varo-wah/wro-angklung-ai-player/docs/hardware.md

# Hardware

## Current Status

The Python pipeline still uses placeholder actuator functions. The website Web Serial driver supports channels 0-17 and sends validated `actuator_schedule.v1` commands to the Arduino Mega firmware. Pause, Stop, completion, and disconnect command all outputs off; E-Stop also disarms firmware output.

The canonical channel, G3-C6 note, angklung-number, and latest physically sweep-tested pin-pair mapping is in `hardware/arduino/README.md`. Firmware uses non-blocking software PWM on the first pin of every driver pair, so ordinary Mega digital pins remain power-adjustable. Every two-pin motor pair remains intact and IN1/IN2 are not reversed. Channel 13 remains assigned to pins 38,39 pending separate diagnosis of its missing physical hit. The corrected firmware compiles successfully but must still be uploaded before this mapping controls the rack.

## Expected Hardware Direction

Future hardware work may include:

- One actuator per angklung note.
- A motor driver, servo driver, relay board, or solenoid driver depending on the final mechanism.
- A microcontroller for precise low-level timing.
- A host computer or single-board computer for AI-assisted song selection and high-level scheduling.

## Hardware Boundary

Python hardware code should enter through `src/actuator_controller.py`. Browser-operated hardware code enters through `frontend/src/lib/arduinoSerial.ts` and the versioned serial protocol in `hardware/arduino/mega_full_18_note/mega_full_18_note.ino`.

The rest of the system should not know whether a note is played by:

- A print statement.
- A GPIO pin.
- A serial command.
- A microcontroller protocol.

This boundary keeps scheduling testable and prevents hardware experiments from destabilizing core playback logic.

## Risks To Validate Later

- Mechanical response delay.
- Actuator reset time.
- Missed or overlapping notes.
- Power draw during chords.
- Timing jitter between host software and physical movement.
- Angklung resonance and damping behavior.
