varo-wah/wro-angklung-ai-player/docs/software.md

# Software

## Current Target

The software target is a website-based AI Angklung Performance Console with reliable control flow before any physical actuator is connected.

The official build order is:

1. Phase 1: Website/control UI and chatbot-style assistant.
2. Phase 2: Reliable preloaded song library and simple song playback.
3. Phase 3: YouTube Piano Reference Mode with user approval.
4. Phase 4: Optional automatic YouTube search plus camera/voice interaction.
5. Phase 5: Hardware driver using the same `actuator_schedule.v1` format.

The current pipeline is:

```text
YouTube URL -> mocked transcription -> internal song JSON -> actuator_schedule.v1
song JSON -> song parser -> instrument mapper -> note scheduler -> actuator controller placeholder
guest request or control-panel selection -> built-in frontend song -> actuator_schedule.v1 -> shared website simulator state
```

The YouTube path is architecture preparation only. It validates source input and produces deterministic mocked notes; it does not search YouTube, download audio, or perform real transcription.

The reliable path is the preloaded supported song library. If a requested song is not preloaded, the frontend must show a limitation message and the future YouTube approval placeholder. It must not imply that every arbitrary song can be played.

The active Phase 2 test library currently keeps `A Whole New World` and the MuseScore-derived `Perfect` arrangement playable on the corrected G3-C6 rack. The older Perfect draft remains inactive because it still uses the old G4-C7 rack and needs remapping. The active arrangements are layered G3-C6 drafts with upper melody notes and lower physical accompaniment. They are playable in the simulator, but remain `demo_safe: false` until listening review, simplification, and hardware validation are complete.

## Song Format

Songs are JSON objects with metadata and a list of notes:

```json
{
  "title": "Example Angklung Pattern",
  "tempo_bpm": 120,
  "notes": [
    {"note": "G4", "start": 0.0, "duration": 0.5}
  ]
}
```

Fields:

- `title`: human-readable song name.
- `tempo_bpm`: positive integer tempo metadata.
- `notes`: non-empty list of note events.
- `note`: angklung note name.
- `start`: note start time in seconds from the beginning of playback.
- `duration`: intended note duration in seconds.

## Timing Model

The scheduler uses monotonic time. This is the correct clock for elapsed-time playback because it is not affected by wall-clock updates.

The scheduler currently:

- Sorts notes by `start`.
- Converts relative note starts into absolute monotonic target times.
- Sleeps until each target time.
- Calls the actuator boundary with expected start time, actual start time, and drift.

## Instrument Mapping

Instrument mappings are stored in `config/instrument_map.json`.

The current physical range is modeled as 18 diatonic notes:

```text
G3 A3 B3 C4 D4 E4 F4
G4 A4 B4 C5 D5 E5 F5
G5 A5 B5 C6
```

Each playable note must resolve to:

- `instrument_id`: the physical angklung identifier.
- `actuator_channel`: the placeholder channel that will later correspond to hardware routing.

Playback fails before scheduling if any song note is missing from the map. Partial playback is not allowed at this stage.

The frontend mirrors this as the current G3-C6 rack in `frontend/src/lib/instrumentMap.ts`. Future conversion must reject unsupported notes such as sharps/flats unless they can be simplified safely into the supported range.

## Actuator Schedule Export

The official command export format is `actuator_schedule.v1`.

Generate an actuator schedule JSON file with:

```bash
python3 src/main.py --song songs/example_song.json --driver json --export outputs/example_schedule.json
```

The export is relative to playback start and is intended for the future website, simulator, and hardware controller layers.

## Website Simulator

The frontend simulator lives in `frontend/`.

It now acts as the Phase 1 AI Angklung Performance Console with three route-based screens:

- `/guest`: a visitor-facing chatbot interface for song requests, supported-song suggestions, simplified playback, and clear unsupported-song messaging.
- `/control`: an operator-facing system monitor with built-in song selection, arrangement controls, schedule generation, validation, virtual rack playback, oscillator tones, timeline preview, JSON preview, and advanced `actuator_schedule.v1` upload.
- `/display`: an audience-facing performance display with assistant status, latest request, selected song, now-playing state, and a decorative music sheet preview.

The screens share frontend state during the browser session. A supported request on `/guest` generates the same schedule and validation state shown on `/control` and the same presentation state shown on `/display`.

For Phase 1 multi-screen demos, browser tabs synchronize through `BroadcastChannel` with `localStorage` as a hydration backup. No backend database is required yet. The tab that starts playback controls audio, while the other tabs mirror playback status and progress visually.

The Phase 2 active song library is currently reset to one test arrangement: `Perfect`. It is loaded from `frontend/public/songs/arrangements/perfect.json` through `frontend/public/songs/catalog.json`, and is marked as a MIDI-derived draft that still needs simplification. It is not demo-safe.

The assistant can match supported song requests against the active library, generate `actuator_schedule.v1`, run validation, and prepare simulation playback when validation does not fail. Unsupported requests show that YouTube Piano Reference Mode is coming later, would require user approval, and that no audio download or transcription is currently running.

Run it with:

```bash
cd frontend
npm install
npm run dev
```

## Testing

Run tests with:

```bash
python3 -m pytest
```

If using the local virtual environment created during setup:

```bash
.venv/bin/python -m pytest
```

## Known Limits

- No hardware control is implemented.
- No real YouTube search, audio download, transcription, camera detection, or voice input is implemented.
- Drift is reported in terminal output, but it is not persisted yet.
- Simultaneous notes are scheduled sequentially in sorted order.
- Tempo is stored as metadata, but notes currently use seconds rather than beats.
