varo-wah/wro-angklung-ai-player/docs/ai/knowledge/wro-demo-explanation.md

# WRO demo explanation

Judge-friendly summary: Angklobot is a local AI-powered robotic angklung system that lets a visitor converse with the machine, choose from validated music, and watch a safe digital arrangement become synchronized angklung actuation.

The AI contribution is local Ollama conversation, intent interpretation, catalog-grounded matching, and recommendations. The robotics contribution is converting validated musical timing into an actuator schedule for a motorized 18-note angklung rack. Validation matters because a plausible AI response is not sufficient evidence that pitches, overlaps, or timings are physically safe.

Local Ollama allows the demo to run on a WRO laptop without depending on cloud connectivity and keeps response data on the machine. Microphone input, local Whisper transcription, the “Hey Angklobot” phrase, text-to-speech, and local MIDI conversion are implemented software features. Camera-based presence detection and complete physical-hardware validation remain future work.
