varo-wah/wro-angklung-ai-player/docs/song-list.md

# Current song list — 10 September 2026

35 musical arrangements and 4 hardware tests are active (39 entries). The legacy out-of-range Perfect draft is inactive; the playable Perfect is the reviewed MuseScore arrangement.

## Pop & ballads (16)

- A Sky Full of Stars
- A Thousand Years
- All of Me
- Count on Me
- Die With a Smile
- Fireflies
- Just the Way You Are
- Love Story
- Memories
- Peaches
- Perfect
- Photograph
- See You Again
- Shape of You
- Someone You Loved
- You Are the Reason

## Rock & classics (4)

- Can't Help Falling in Love
- Viva La Vida
- We Are the Champions
- Yellow

## Film & musicals (5)

- A Whole New World
- Golden
- Let It Go
- Mission: Impossible Theme
- Under the Sea

## Traditional & folk (4)

- Bengawan Solo
- Bubuy Bulan
- Manuk Dadali
- Tokecang

## Indonesian national (3)

- Indonesia Pusaka
- Indonesia Raya
- Tanah Airku

## Indonesian pop (2)

- Lantas
- Laskar Pelangi (supplied-score draft)

## Instrumental (1)

- River Flows in You

## Hardware tests (4)

- 5-7-2-4 Cycle
- 5-7-2-4 Ping-Pong
- Cross Pattern
- Full Rack Sweep

We Are the Champions starts at its first chorus. Melody only / Melody with Extra is available across the library; Extra plays only the authored support parts when present. All scheduled holds follow the two-second cap and release-gap policy.
