varo-wah/wro-angklung-ai-player/frontend/scripts/sources/You_Are_The_Reason_Dynamic_Hold_Softer_Lows.ino

/*
  YOU ARE THE REASON - ANGKLOBOT
  Target: Arduino Mega 2560

  Motor system:
    - 18 channels
    - paired IN1 / IN2 pins
    - software PWM at 1 kHz
    - individual motor power percentages
    - note-length-aware motor pulses up to 300 ms
    - non-blocking playback for overlapping notes

  Song:
    - full 827-event arrangement
    - manual start only; no autoplay

  Serial:
    P = play/restart
    S = stop
    T = status
*/

#include <Arduino.h>
#include <avr/pgmspace.h>

constexpr uint8_t CHANNEL_COUNT = 18;
constexpr uint16_t PWM_PERIOD_US = 1000;
constexpr uint16_t MAX_PULSE_DURATION_MS = 300;
constexpr unsigned long SERIAL_BAUD = 115200;

// 0=G3, 1=A3, 2=B3, 3=C4, 4=D4, 5=E4, 6=F4,
// 7=G4, 8=A4, 9=B4, 10=C5, 11=D5, 12=E5,
// 13=F5, 14=G5, 15=A5, 16=B5, 17=C6

const uint8_t IN1_PINS[CHANNEL_COUNT] = {
  6, 8, 2, 4, 28, 26, 32, 30, 12,
  10, 24, 22, 36, 34, 41, 38, 44, 42
};

const uint8_t IN2_PINS[CHANNEL_COUNT] = {
  7, 9, 3, 5, 29, 27, 33, 31, 14,
  11, 25, 23, 37, 35, 42, 39, 45, 43
};

// Per-note power percentages.
uint8_t motorPowerPercent[CHANNEL_COUNT] = {
  50, 40, 40, 40, 40, 40, 40, 40, 40,
  40, 50, 40, 40, 40, 40, 40, 40, 40
};

struct MotorState {
  bool active;
  bool outputHigh;
  uint16_t dutyPermille;
  unsigned long pulseEndMs;
  unsigned long pwmCycleStartUs;
};

MotorState motors[CHANNEL_COUNT];

struct __attribute__((packed)) SongEvent {
  uint32_t startMs;
  uint16_t durationMs;
  uint8_t channel;
};

const SongEvent SONG[] PROGMEM = {
  {0UL, 260, 3},
  {350UL, 148, 0},
  {700UL, 148, 0},
  {1045UL, 148, 3},
  {1395UL, 148, 0},
  {1745UL, 148, 0},
  {2095UL, 148, 3},
  {2440UL, 148, 0},
  {2790UL, 148, 0},
  {3140UL, 148, 3},
  {3490UL, 148, 0},
  {3835UL, 148, 0},
  {4185UL, 260, 1},
  {4185UL, 148, 3},
  {4535UL, 148, 0},
  {4885UL, 148, 0},
  {5235UL, 148, 3},
  {5580UL, 148, 0},
  {5930UL, 148, 0},
  {6280UL, 148, 3},
  {6630UL, 148, 0},
  {6975UL, 148, 0},
  {7325UL, 148, 3},
  {7675UL, 148, 0},
  {8025UL, 148, 0},
  {8370UL, 148, 3},
  {8370UL, 260, 6},
  {8720UL, 148, 0},
  {9070UL, 148, 0},
  {9420UL, 148, 3},
  {9765UL, 148, 0},
  {10115UL, 148, 0},
  {10465UL, 260, 0},
  {10465UL, 148, 2},
  {10815UL, 148, 0},
  {11165UL, 148, 0},
  {11510UL, 148, 2},
  {11860UL, 148, 0},
  {12210UL, 148, 0},
  {12560UL, 260, 3},
  {12905UL, 148, 0},
  {13255UL, 148, 0},
  {13605UL, 148, 3},
  {13955UL, 148, 0},
  {14300UL, 148, 0},
  {14650UL, 148, 3},
  {15000UL, 148, 0},
  {15350UL, 148, 0},
  {15700UL, 148, 3},
  {15700UL, 257, 12},
  {16045UL, 148, 0},
  {16045UL, 257, 11},
  {16395UL, 148, 0},
  {16395UL, 257, 10},
  {16745UL, 260, 3},
  {16745UL, 300, 10},
  {17095UL, 148, 0},
  {17440UL, 148, 0},
  {17790UL, 148, 3},
  {17790UL, 300, 10},
  {18140UL, 148, 0},
  {18490UL, 148, 0},
  {18490UL, 257, 8},
  {18835UL, 148, 3},
  {19185UL, 148, 0},
  {19535UL, 148, 0},
  {19535UL, 257, 7},
  {19885UL, 148, 3},
  {19885UL, 257, 10},
  {20235UL, 148, 0},
  {20235UL, 257, 11},
  {20580UL, 148, 0},
  {20580UL, 257, 12},
  {20930UL, 260, 1},
  {20930UL, 148, 3},
  {20930UL, 300, 10},
  {21280UL, 148, 0},
  {21630UL, 148, 0},
  {21630UL, 300, 8},
  {21975UL, 148, 3},
  {22325UL, 148, 0},
  {22675UL, 148, 0},
  {23025UL, 148, 3},
  {23370UL, 148, 0},
  {23720UL, 148, 0},
  {23720UL, 257, 7},
  {24070UL, 148, 3},
  {24070UL, 257, 10},
  {24420UL, 148, 0},
  {24420UL, 257, 11},
  {24765UL, 148, 0},
  {24765UL, 257, 12},
  {25115UL, 148, 3},
  {25115UL, 260, 6},
  {25115UL, 300, 8},
  {25465UL, 148, 0},
  {25815UL, 148, 0},
  {26165UL, 148, 3},
  {26510UL, 148, 0},
  {26860UL, 148, 0},
  {27210UL, 260, 0},
  {27210UL, 148, 2},
  {27560UL, 148, 0},
  {27905UL, 148, 0},
  {27905UL, 257, 10},
  {28255UL, 148, 2},
  {28255UL, 300, 10},
  {28605UL, 148, 0},
  {28955UL, 148, 0},
  {28955UL, 257, 4},
  {29300UL, 260, 3},
  {29300UL, 300, 5},
  {29650UL, 148, 0},
  {30000UL, 148, 0},
  {30350UL, 148, 3},
  {30700UL, 148, 0},
  {31045UL, 148, 0},
  {31395UL, 148, 3},
  {31745UL, 148, 0},
  {32095UL, 148, 0},
  {32270UL, 128, 10},
  {32440UL, 148, 3},
  {32440UL, 257, 12},
  {32790UL, 148, 0},
  {32790UL, 257, 11},
  {33140UL, 148, 0},
  {33140UL, 257, 10},
  {33490UL, 260, 3},
  {33490UL, 300, 10},
  {33835UL, 148, 0},
  {34185UL, 148, 0},
  {34535UL, 148, 3},
  {34535UL, 300, 10},
  {34885UL, 148, 0},
  {35235UL, 148, 0},
  {35235UL, 257, 8},
  {35580UL, 148, 3},
  {35930UL, 148, 0},
  {36280UL, 148, 0},
  {36280UL, 257, 7},
  {36630UL, 148, 3},
  {36630UL, 257, 10},
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
  {168490UL, 180, 1},
  {168490UL, 180, 6},
  {168490UL, 300, 15},
  {169185UL, 148, 0},
  {169535UL, 260, 0},
  {169535UL, 180, 4},
  {170235UL, 257, 13},
  {170580UL, 257, 15},
  {170930UL, 257, 14},
  {171280UL, 257, 13},
  {171630UL, 260, 1},
  {171630UL, 180, 5},
  {171630UL, 300, 12},
  {172675UL, 180, 5},
  {172675UL, 300, 12},
  {173370UL, 148, 5},
  {173720UL, 180, 1},
  {173720UL, 180, 3},
  {174770UL, 180, 0},
  {174770UL, 180, 5},
  {174770UL, 257, 10},
  {175115UL, 257, 12},
  {175465UL, 257, 14},
  {175815UL, 180, 3},
  {175815UL, 180, 6},
  {175815UL, 300, 15},
  {176165UL, 248, 3},
  {176860UL, 180, 1},
  {176860UL, 180, 6},
  {176860UL, 300, 15},
  {177560UL, 148, 0},
  {177905UL, 260, 0},
  {177905UL, 180, 2},
  {177905UL, 180, 4},
  {178605UL, 257, 12},
  {178955UL, 257, 15},
  {179305UL, 257, 14},
  {179650UL, 257, 13},
  {180000UL, 260, 3},
  {180000UL, 180, 5},
  {180000UL, 300, 12},
  {181045UL, 180, 0},
  {181045UL, 180, 5},
  {181045UL, 300, 12},
  {182095UL, 180, 3},
  {182095UL, 180, 5},
  {183140UL, 180, 0},
  {183140UL, 180, 2},
  {183140UL, 180, 4},
  {183840UL, 257, 10},
  {184185UL, 180, 1},
  {184185UL, 180, 3},
  {184185UL, 180, 5},
  {184185UL, 300, 10},
  {185235UL, 180, 0},
  {185235UL, 180, 2},
  {185235UL, 180, 4},
  {185235UL, 300, 11},
  {186280UL, 180, 0},
  {186280UL, 180, 3},
  {186280UL, 180, 5},
  {186280UL, 300, 12},
  {187325UL, 180, 0},
  {187325UL, 180, 3},
  {187325UL, 180, 5},
  {187325UL, 300, 17},
  {188025UL, 257, 16},
  {188375UL, 180, 1},
  {188375UL, 260, 3},
  {188375UL, 260, 6},
  {188375UL, 300, 15},
  {190465UL, 180, 1},
  {190465UL, 180, 4},
  {191165UL, 257, 10},
  {191510UL, 257, 11},
  {191860UL, 257, 11},
  {192210UL, 128, 10},
  {192385UL, 257, 12},
  {192560UL, 180, 0},
  {192560UL, 260, 3},
  {192560UL, 260, 5},
  {192735UL, 128, 11},
  {192905UL, 300, 10},
};

constexpr uint16_t EVENT_COUNT = sizeof(SONG) / sizeof(SONG[0]);
constexpr uint32_t SONG_END_MS = 193600UL;

bool playing = false;
bool completionPrinted = false;
uint16_t nextEventIndex = 0;
unsigned long songStartMs = 0;

bool deadlineReached(unsigned long now, unsigned long deadline) {
  return (long)(now - deadline) >= 0;
}

void writeMotorPinsLow(uint8_t channel) {
  digitalWrite(IN1_PINS[channel], LOW);
  digitalWrite(IN2_PINS[channel], LOW);
}

void stopMotor(uint8_t channel) {
  writeMotorPinsLow(channel);
  motors[channel].active = false;
  motors[channel].outputHigh = false;
  motors[channel].dutyPermille = 0;
}

void allOff() {
  for (uint8_t channel = 0; channel < CHANNEL_COUNT; channel++) {
    stopMotor(channel);
  }
}

void startMotorPulse(uint8_t channel, uint16_t requestedDurationMs) {
  if (channel >= CHANNEL_COUNT) return;

  // Preserve the musical duration stored in each song event.
  // Short notes remain short, while 248/257/260/300 ms events are
  // now allowed to sustain instead of being chopped to 180 ms.
  const uint16_t durationMs =
      requestedDurationMs > MAX_PULSE_DURATION_MS
          ? MAX_PULSE_DURATION_MS
          : requestedDurationMs;

  uint16_t dutyPermille =
      (uint16_t)motorPowerPercent[channel] * 10U;

  // The repeated low-register accompaniment is intentionally softer.
  // Only short low notes are reduced, so longer low melody/bass notes
  // can still speak clearly.
  const bool lowRepeatingAccompaniment =
      (channel <= 6 && requestedDurationMs <= 180);

  if (lowRepeatingAccompaniment) {
    dutyPermille = (uint32_t)dutyPermille * 80UL / 100UL;
  }

  writeMotorPinsLow(channel);

  motors[channel].active = dutyPermille > 0;
  motors[channel].outputHigh = false;
  motors[channel].dutyPermille = dutyPermille;
  motors[channel].pulseEndMs = millis() + durationMs;
  motors[channel].pwmCycleStartUs = micros();
}

void updateMotorPulseExpiry() {
  const unsigned long nowMs = millis();

  for (uint8_t channel = 0; channel < CHANNEL_COUNT; channel++) {
    if (motors[channel].active &&
        deadlineReached(nowMs, motors[channel].pulseEndMs)) {
      stopMotor(channel);
    }
  }
}

void updateSoftwarePwm() {
  const unsigned long nowUs = micros();

  for (uint8_t channel = 0; channel < CHANNEL_COUNT; channel++) {
    MotorState &motor = motors[channel];
    if (!motor.active) continue;

    unsigned long phaseUs = nowUs - motor.pwmCycleStartUs;

    if (phaseUs >= PWM_PERIOD_US) {
      motor.pwmCycleStartUs +=
          (phaseUs / PWM_PERIOD_US) * PWM_PERIOD_US;
      phaseUs %= PWM_PERIOD_US;
    }

    const unsigned long onTimeUs =
        (unsigned long)PWM_PERIOD_US *
        motor.dutyPermille / 1000UL;

    const bool shouldBeHigh = phaseUs < onTimeUs;

    if (shouldBeHigh != motor.outputHigh) {
      digitalWrite(IN2_PINS[channel], LOW);
      digitalWrite(IN1_PINS[channel], shouldBeHigh ? HIGH : LOW);
      motor.outputHigh = shouldBeHigh;
    }
  }
}

SongEvent readSongEvent(uint16_t index) {
  SongEvent event;
  memcpy_P(&event, &SONG[index], sizeof(SongEvent));
  return event;
}

void beginPlayback() {
  allOff();
  nextEventIndex = 0;
  songStartMs = millis();
  playing = true;
  completionPrinted = false;

  Serial.print(F("PLAYING YOU ARE THE REASON - EVENTS="));
  Serial.println(EVENT_COUNT);
}

void stopPlayback() {
  playing = false;
  allOff();
  Serial.println(F("STOPPED"));
}

void processSongEvents() {
  if (!playing) return;

  const uint32_t elapsedMs = millis() - songStartMs;

  while (nextEventIndex < EVENT_COUNT) {
    const SongEvent event = readSongEvent(nextEventIndex);

    if ((int32_t)(elapsedMs - event.startMs) < 0) break;

    startMotorPulse(event.channel, event.durationMs);
    nextEventIndex++;
  }

  if (nextEventIndex >= EVENT_COUNT && elapsedMs >= SONG_END_MS) {
    playing = false;
    allOff();

    if (!completionPrinted) {
      completionPrinted = true;
      Serial.println(F("YOU ARE THE REASON COMPLETE"));
    }
  }
}

void processSerial() {
  while (Serial.available() > 0) {
    const char command = Serial.read();

    if (command == 'P' || command == 'p') {
      beginPlayback();
    } else if (command == 'S' || command == 's') {
      stopPlayback();
    } else if (command == 'T' || command == 't') {
      Serial.print(F("PLAYING="));
      Serial.print(playing ? F("TRUE") : F("FALSE"));
      Serial.print(F(", EVENT="));
      Serial.print(nextEventIndex);
      Serial.print('/');
      Serial.println(EVENT_COUNT);
    }
  }
}

void setup() {
  for (uint8_t channel = 0; channel < CHANNEL_COUNT; channel++) {
    digitalWrite(IN1_PINS[channel], LOW);
    digitalWrite(IN2_PINS[channel], LOW);

    pinMode(IN1_PINS[channel], OUTPUT);
    pinMode(IN2_PINS[channel], OUTPUT);

    motors[channel].active = false;
    motors[channel].outputHigh = false;
    motors[channel].dutyPermille = 0;
    motors[channel].pulseEndMs = 0;
    motors[channel].pwmCycleStartUs = 0;

    writeMotorPinsLow(channel);
  }

  Serial.begin(SERIAL_BAUD);
  Serial.println(F("ANGKLOBOT - YOU ARE THE REASON"));
  Serial.println(F("Manual start only. Press P to play."));
  Serial.println(F("P=PLAY/RESTART, S=STOP, T=STATUS"));
}

void loop() {
  processSerial();


  processSongEvents();
  updateMotorPulseExpiry();
  updateSoftwarePwm();
}
