varo-wah/wro-angklung-ai-player/hardware/arduino/mega_full_18_note_web_serial/tests/protocol_test.cpp

#include <cassert>
#include <cstring>
#include <iostream>
#include "../mega_full_18_note_web_serial.ino"

void send(const char *line) {
  char buffer[64];
  strcpy(buffer, line);
  Serial.output.clear();
  handleCommand(buffer);
}
void off() {
  for (int i = 0; i < 18; ++i) {
    assert(!motors[i].active);
    assert(fakePinValues[IN1_PINS[i]] == LOW);
    assert(fakePinValues[IN2_PINS[i]] == LOW);
  }
}
int main() {
  setup(); assert(!armed); off();
  send("HELLO,1"); assert(Serial.output == "READY,1,ACTIVE\n"); assert(!armed);
  send("HELLO,2"); assert(Serial.output == "ERROR,PROTOCOL_VERSION\n");
  send("NOTE,0,300,1000"); assert(Serial.output == "ERROR,NOT_ARMED\n"); off();
  send("ARM"); assert(armed); off();
  const uint8_t expectedPower[18] = {30,28,30,30,30,30,25,30,25,30,30,25,25,25,55,35,22,25};
  for (int i=0; i<18; ++i) {
    assert(motorPowerPercent[i] == expectedPower[i]); assert(motorPulseMs[i] == 550);
    std::string note = "NOTE," + std::to_string(i) + ",5000,1000";
    send(note.c_str()); assert(motors[i].active);
    assert(motors[i].dutyPermille == (uint16_t)expectedPower[i] * 15U);
    assert(motors[i].pulseEndMs == fakeMillis + 5000);
  }
  send("ALL_OFF"); assert(armed); off();
  motorPowerPercent[0]=100;
  send("NOTE,0,300,1000"); assert(motors[0].dutyPermille==1000);
  send("NOTE,0,300,0"); assert(motors[0].dutyPermille==0);
  motorPowerPercent[0]=30;
  send("ALL_OFF"); off();
  send("NOTE,0,300,500"); send("NOTE,1,200,1000");
  assert(motors[0].active && motors[1].active);
  assert(motors[0].dutyPermille == 225);
  updateSoftwarePwm(); assert(fakePinValues[6] == HIGH);
  fakeMicros=225; updateSoftwarePwm(); assert(fakePinValues[6] == LOW);
  fakeMillis=100; send("NOTE,0,550,1000"); assert(motors[0].pulseEndMs == 650);
  fakeMillis=200; updateMotorPulseExpiry(); assert(!motors[1].active && motors[0].active);
  fakeMillis=650; updateMotorPulseExpiry(); off();
  for (const char *bad : {"NOTE,-1,300,1000", "NOTE,18,300,1000", "NOTE,0,0,1000", "NOTE,0,5001,1000", "NOTE,0,300,1001", "NOTE,0,,1000", "NOTE,0,300,1000,", "NOTE,0,300,9999999999999999999"}) {
    send(bad); assert(Serial.output.find("ERROR,") == 0); off();
  }
  for (const char *stop : {"STOP", "DISARM", "ESTOP"}) {
    send("ARM"); send("NOTE,0,300,1000"); updateSoftwarePwm();
    send(stop); off(); assert(armed == (strcmp(stop,"STOP") == 0));
  }
  send("MANUAL_CAPS"); assert(Serial.output == "CAPS,MANUAL_RAW,100,250\n");
  send("DISARM"); send("MANUAL,0,100"); off();
  send("ARM");
  for (int channel=0; channel<18; channel++) {
    for (int power : {0, 30, 60, 100}) {
      std::string manual = "MANUAL," + std::to_string(channel) + "," + std::to_string(power);
      send(manual.c_str());
      assert(motors[channel].dutyPermille == power * 10);
      assert(motors[channel].pulseEndMs == fakeMillis + 250);
      for (int other=0; other<18; other++) if (other!=channel) assert(!motors[other].active);
    }
  }
  fakeMillis += 251; updateMotorPulseExpiry(); off();
  for (const char *bad : {"MANUAL,18,100", "MANUAL,0,101", "MANUAL,-1,100", "MANUAL,0,-1", "MANUAL,0,30,20"}) {
    send(bad); assert(Serial.output.find("ERROR,") == 0); off();
  }
  send("MANUAL,0,100"); send("DISARM"); off();
  std::cout << "USB firmware host tests passed (physical pin conflict unverified)\n";
}
