varo-wah/wro-angklung-ai-player/firmware/esp32/angklobot_bridge/bridge_config.example.h

#pragma once
// Copy to bridge_config.h (ignored by Git). Use a trusted isolated local Wi-Fi.
#define WIFI_SSID "YOUR_LOCAL_WIFI"
#define WIFI_PASSWORD "YOUR_WIFI_PASSWORD"
#define BRIDGE_TOKEN "CHANGE_ME"
