varo-wah/wro-angklung-ai-player/(commit log)

2026-06-24 Add JSON actuator schedule export
2026-06-26 Add layered angklung arrangements and relax motor limits
2026-06-28 Add actuator strength setting
2026-06-28 Refine angklung console messaging and assistant flow
2026-08-08 Add Arduino Do Mi Sol fallback sketch
2026-08-16 Add website Arduino serial control
2026-08-25 Replace Do Mi Sol trial with Mega four-note setup
    [mega_low_5724_trial.ino]
2026-09-05 Add full-rack Mega calibration firmware
2026-09-05 Correct full-rack angklung assignments
    [firmware_protocol_test.cpp, mega_full_18_note.ino]
2026-09-05 Correct adjacent Mega pin-pair assignments
    [firmware_protocol_test.cpp, mega_full_18_note.ino]
2026-09-10 Preserve integrated song, remote control, and ESP32 work before competition merge
2026-09-10 Restore previous wake sweep power and timing
2026-09-11 Default to melody with extras and add spoken arrangement switching
2026-10-31 Snapshot current Studio source for isolated conducting integration
2026-10-31 Add isolated camera conducting preview to Studio
2026-10-31 Unify Studio appearance and resizing with camera conducting preview
2026-11-14 Add hold-to-play manual motor controls to Studio
2026-11-14 Separate direct manual PWM power from calibrated song strength
2026-11-14 Allow typing manual motor power alongside the slider
2026-11-14 Serialize manual arming and acknowledge motor commands
